NikolaZaric98/Boat_BLE/README.md

# Boat_BLE
### Projekat: Brodić koji se upravlja preko bluetooth aplikacije na telefonu.
### U sklopu ovog foldera nalazi se kompletan izveštaj gde su do detalja opisane sve komponente koje su korišćene i sam kod.
